JoanaCatarino/Adaptive-decision-making-task/Images/23.png

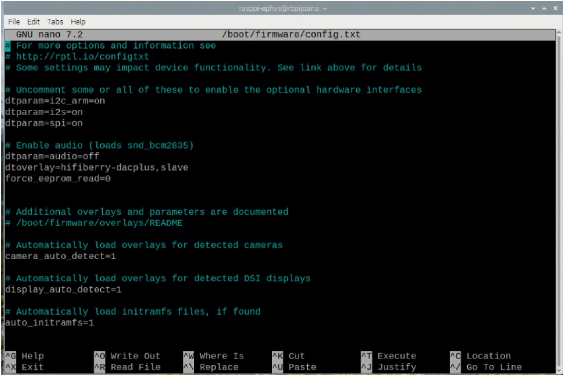
Images/23.png
