JoanaCatarino/Adaptive-decision-making-task/Task_GUI_Joana/gui_controls.py

# -*- coding: utf-8 -*-
"""
Created on Wed Oct  2 15:09:03 2024

@author: JoanaCatarino
"""
import matplotlib
matplotlib.use('Qt5Agg')

import sys
import cv2
import threading
import serial
import time
import random
import subprocess

import asyncio

from PyQt5.QtWidgets import QApplication, QWidget, QVBoxLayout, QLabel, QMainWindow, QSizePolicy
from PyQt5.QtGui import QFont, QImage, QPixmap
from PyQt5.QtCore import pyqtSlot, QTimer, QDate, Qt, QThread
from PyQt5.QtGui import QIntValidator, QDoubleValidator
from qasync import QEventLoop, asyncSlot  # Import qasync for async integration
from form_updt import Ui_TaskGui

# Import different functions/classes
from animal_id_generator import animal_id
from box_generator import box
from task_generator import task
from date_updater import DateUpdater
from chronometer_generator import Chronometer
from file_writer import create_data_file
from stylesheet import stylesheet
from camera_thread import CameraThread
from piezo_plot import LivePlotWidget
from performance_plot import PlotLicks
from performance_plot_advanced import PlotPerformance
from piezo_reader import PiezoReader
from calibration_pumps import calibration_pumps
from calibration_opto_10ms import calibration_opto_10ms
from calibration_opto_100ms import calibration_opto_100ms
from gpio_map import *

# Import task classes
from task_test_rig import TestRig
from task_free_licking import FreeLickingTask
from task_twochoice_auditory_blocks import TwoChoiceAuditoryTask_Blocks
from task_twochoice_auditory import TwoChoiceAuditoryTask
from task_adaptive_sensorimotor import AdaptiveSensorimotorTask
from task_adaptive_sensorimotor_distractor import AdaptiveSensorimotorTaskDistractor

# Import recording protocols as tasks
from passive_protocol_sounds import PassiveSoundRecordings



class GuiControls:
    def __init__(self, ui, updateTime_slot):
        self.ui = ui
        self.updateTime_slot = updateTime_slot

        style = stylesheet(self.ui) # to call the function with buttons' stylesheet
        self.current_task = None # set the initial task value
        self.camera_thread = None

        # initialize components defined by functions:
        self.populate_ddm_animalID() # dropdown menu with animal IDs
        self.populate_ddm_box() # dropdown menu with box numbers
        self.OV_animalID() # txt with animal ID in overview tab
        self.OV_box() # txt with box number in the overview tab
        self.OV_task() # txt with task protocol name in the overview tab
        self.populate_ddm_task() # dropdown menu with different task names
        self.setup_date() # Date
        self.setup_chronometer() # Chronometer
        self.connect_buttons() # Start, Stop and Update buttons
        self.disable_controls() # Disable all the controls for the test rig 'task' - Can only be activated when task is selected
        self.connect_text_changes() # inputs received in the QLineEdits
        self.check_update_state()
        self.camera_timer = QTimer()
        self.cap = cv2.VideoCapture() # initializing cam without open
        stylesheet(self.ui)
        
        # Connect dropdown menu with animal ID in box tab to the animal ID txt in the overview tab
        self.ui.ddm_Animal_ID.currentIndexChanged.connect(self.OV_animalID)
        # Connect dropdown menu with box number to the box txt in the overview tab
        self.ui.ddm_Box.currentIndexChanged.connect(self.OV_box)
        # Connect dropdown menu with task protocol to the task txt in the overview tab
        self.ui.ddm_Task.currentIndexChanged.connect(self.OV_task)
        # Initialize button states (to enable/disable start and stop buttons)
        self.update_button_states()
        # Initialize validators for QLineEdit widgets - to only accept numbers as input
        self.setup_validators()
        # Connect the task combobox to the method for enabling/disabling QLineEdits
        self.ui.ddm_Task.currentIndexChanged.connect(self.update_qlineedit_states)
        # Connect dropdown menu changes to check start button state method (so that you need to select animal info before starting the task)
        self.ui.ddm_Animal_ID.currentIndexChanged.connect(self.check_start_button_state)
        self.ui.ddm_Task.currentIndexChanged.connect(self.check_start_button_state)
        self.ui.ddm_Box.currentIndexChanged.connect(self.check_start_button_state)
        # Initial buttom state check
        self.check_start_button_state

        # Initialize funtions related to piezo
        self.piezo_reader = PiezoReader() # Initialize piezo reader
        self.setup_piezo_plots() # Set up the piezo plot
        self.piezo_timer = QTimer()
        self.piezo_timer.timeout.connect(self.update_piezo_plots)
        self.piezo_timer.setInterval(20)  # Refresh every 20 ms
        
        # Initialize functions for the performance plot
        self.setup_lick_plot()
        self.setup_performance_plot()
        
        # Set correct ranges for sliders based on your camera's capabilities
        self.ui.bar_Exposure.setMinimum(10)
        self.ui.bar_Exposure.setMaximum(626)
        
        self.ui.bar_Brightness.setMinimum(-64)
        self.ui.bar_Brightness.setMaximum(64)
        
        self.ui.bar_Contrast.setMinimum(0)
        self.ui.bar_Contrast.setMaximum(95)
            

    #Piezo functions
    def setup_piezo_plots(self):

        # Place live plots into GUI layout
        plt_layout1 = QVBoxLayout(self.ui.plt_LickTrace_Left)
        plt_layout1.setContentsMargins(0, 0, 0, 0)
        plt_layout1.setSpacing(0)
        self.live_plot1 = LivePlotWidget(self.piezo_reader.max_data_points, color= '#955C66', parent=self.ui.plt_LickTrace_Left)
        self.live_plot1.setSizePolicy(QSizePolicy.Expanding, QSizePolicy.Expanding)
        plt_layout1.addWidget(self.live_plot1)
        self.ui.plt_LickTrace_Left.setLayout(plt_layout1)

        plt_layout2 = QVBoxLayout(self.ui.plt_LickTrace_Right)
        plt_layout2.setContentsMargins(0, 0, 0, 0)
        plt_layout2.setSpacing(0)
        self.live_plot2 = LivePlotWidget(self.piezo_reader.max_data_points, color= '#4E8070', parent=self.ui.plt_LickTrace_Right)
        self.live_plot2.setSizePolicy(QSizePolicy.Expanding, QSizePolicy.Expanding)
        plt_layout2.addWidget(self.live_plot2)
        self.ui.plt_LickTrace_Right.setLayout(plt_layout2)

    def update_piezo_plots(self):
        # read serial data
        self.piezo_reader.read_serial_data()
        # Update each piezo plot with new data
        self.live_plot1.update_plot(self.piezo_reader.piezo_adder1)  # Update Left Piezo Plot
        self.live_plot2.update_plot(self.piezo_reader.piezo_adder2)  # Update Right Piezo Plot
        
    
    def setup_lick_plot(self):
        # Licks plot in the main tab
        plt_layout1 = QVBoxLayout(self.ui.plt_AnimalPerformance)
        plt_layout1.setContentsMargins(0, 0, 0, 0)
        plt_layout1.setSpacing(0)
        
        self.lick_plot = PlotLicks(parent=self.ui.plt_AnimalPerformance)  # Create stair plot
        self.lick_plot.setSizePolicy(QSizePolicy.Expanding, QSizePolicy.Expanding)
        
        plt_layout1.addWidget(self.lick_plot)
        self.ui.plt_AnimalPerformance.setLayout(plt_layout1)
        
        # Licks plot in the overview tab
        plt_layout2 = QVBoxLayout(self.ui.plt_AnimalPerformance)
        plt_layout2.setContentsMargins(0, 0, 0, 0)
        plt_layout2.setSpacing(0)
        
        self.lick_plot_ov = PlotLicks(parent=self.ui.OV_plt_AnimalPerformance)  # Create stair plot
        self.lick_plot_ov.setSizePolicy(QSizePolicy.Expanding, QSizePolicy.Expanding)
        
        plt_layout2.addWidget(self.lick_plot_ov)
        self.ui.OV_plt_AnimalPerformance.setLayout(plt_layout2)

    
    def update_lick_plot(self, total_licks, licks_left, licks_right, total_trials):
        if hasattr(self, 'lick_plot'):
            self.lick_plot.update_plot(total_licks, licks_left, licks_right, total_trials)
            
        if hasattr(self, 'lick_plot_ov'):
            self.lick_plot_ov.update_plot(total_licks, licks_left, licks_right, total_trials)
            
    
    def setup_performance_plot(self):
        # Licks plot in the main tab
        plt_layout1 = QVBoxLayout(self.ui.plt_AnimalPerformance)
        plt_layout1.setContentsMargins(0, 0, 0, 0)
        plt_layout1.setSpacing(0)
        
        self.performance_plot = PlotPerformance(parent=self.ui.plt_AnimalPerformance)  # Create stair plot
        self.performance_plot.setSizePolicy(QSizePolicy.Expanding, QSizePolicy.Expanding)
        
        plt_layout1.addWidget(self.performance_plot)
        self.ui.plt_AnimalPerformance.setLayout(plt_layout1)
        
        # Licks plot in the overview tab
        plt_layout2 = QVBoxLayout(self.ui.plt_AnimalPerformance)
        plt_layout2.setContentsMargins(0, 0, 0, 0)
        plt_layout2.setSpacing(0)
        
        self.performance_plot_ov = PlotPerformance(parent=self.ui.OV_plt_AnimalPerformance)  # Create stair plot
        self.performance_plot_ov.setSizePolicy(QSizePolicy.Expanding, QSizePolicy.Expanding)
        
        plt_layout2.addWidget(self.performance_plot_ov)
        self.ui.OV_plt_AnimalPerformance.setLayout(plt_layout2)

    
    def update_performance_plot(self, total_trials, correct_trials, incorrect_trials):
        if hasattr(self, 'performance_plot'):
            self.performance_plot.update_plot(total_trials, correct_trials, incorrect_trials)
            
        if hasattr(self, 'performance_plot_ov'):
            self.performance_plot_ov.update_plot(total_trials, correct_trials, incorrect_trials)  
    
    
    def populate_ddm_animalID(self):
        # Populate the dropdown menu for Animal_ID
        font_size = 8
        animal_id(self.ui.ddm_Animal_ID)


    def OV_animalID(self):
        selected_animal = self.ui.ddm_Animal_ID.currentText() # Covert string to integer

        # Check if the selected value is numeric (integer or float)
        if selected_animal.replace('.', '', 1).isdigit():  # Checks for integers and floats
            if '.' in selected_animal:
                selected_animal = float(selected_animal)  # Convert to float if it has a decimal point
            else:
                selected_animal = int(selected_animal)  # Convert to integer if no decimal point

        # Update the txt, whether it's a string or a number
        self.ui.OV_txt_AnimalID.setText(f'{selected_animal}')

    def populate_ddm_box(self):
        # populate the dropdown menu for box
        font_size = 8
        box(self.ui.ddm_Box)

    def OV_box(self):
        selected_box = self.ui.ddm_Box.currentText()

        if selected_box.replace('.', '', 1).isdigit():
            if '.' in selected_box:
                selected_box = float(selected_box)
            else:
                selected_box = int(selected_box)

        self.ui.OV_txt_Box.setText(f'{selected_box}')

    def populate_ddm_task(self):
        font_size = 8
        task(self.ui.ddm_Task, font_size=8)
        
   
    def OV_task(self):
        selected_task = self.ui.ddm_Task.currentText()
        self.ui.OV_txt_Task.setText(f'{selected_task}')


    def setup_date(self):
        # Create and configure a DateUpdater
        self.date_updater = DateUpdater(self.ui.txt_Date, font_size=9)


    def setup_chronometer(self):
        # Initialize Chronometer
        self.txt_Chronometer = Chronometer() # Chronometer for general box tab
        self.txt_Chronometer.timeChanged.connect(self.updateTime_slot)

        self.OV_box_Chronometer = Chronometer() # Chronometer Overview tab
        self.OV_box_Chronometer.timeChanged.connect(self.updateTime_slot)
        
    
    def calibration(self):
        try:
            print('Starting calibration of pumps')
            calibration_pumps()
        except Exception as e:
            print(f'Calibration failed:{e}')
            
    def test_opto_10ms(self):
        try:
            print('Starting test for 10ms opto')
            calibration_opto_10ms()
        except Exception as e:
            print(f'Test failed:{e}')
            
    def test_opto_100ms(self):
        try:
            print('Starting test for 100ms opto')
            calibration_opto_100ms()
        except Exception as e:
            print(f'Test failed:{e}')
            
            
            
    '''
    def start_camera(self):
        start_camera(self.cap, self.camera_timer, self.update_frame)

    def stop_camera(self):
        stop_camera(self.cap, self.ui.plt_Camera, self.ui.OV_plt_Camera)

    def update_frame(self):
        update_frame(self.cap, self.ui.plt_Camera, self.ui.OV_plt_Camera)
    '''
    
    def start_camera(self): 
        self.camera_thread = CameraThread()
        self.camera_thread.frameCaptured.connect(self.update_frame)
        self.camera_thread.cameraStatus.connect(self.update_camera_status)
        self.camera_thread.start()
        
    def update_camera_status(self, status):
        if status:
            self.ui.lbl_CameraStatus.setText("Connected")
            self.ui.lbl_CameraStatus.setStyleSheet("color: green;")
        else:
            self.ui.lbl_CameraStatus.setText("Not connected")
            self.ui.lbl_CameraStatus.setStyleSheet("color: red;")
        
    def stop_camera(self):
        if self.camera_thread:
            self.camera_thread.stop()
            self.camera_thread = None
    
        # Clear camera display in GUI widgets
        self.ui.plt_Camera.clear()
        self.ui.OV_plt_Camera.clear()
    
    def update_frame(self, frame):
        frame = cv2.cvtColor(frame, cv2.COLOR_BGR2GRAY)
        h, w = frame.shape
        bytes_per_line = w
        image = QImage(frame.data, w, h, bytes_per_line, QImage.Format_Grayscale8)
        pixmap = QPixmap.fromImage(image)
    
        # Update both camera display widgets
        self.ui.plt_Camera.setPixmap(pixmap.scaled(self.ui.plt_Camera.size(), Qt.KeepAspectRatio))
        self.ui.OV_plt_Camera.setPixmap(pixmap.scaled(self.ui.OV_plt_Camera.size(), Qt.KeepAspectRatio))
        
    def update_camera_exposure(self, value):
        # Disable auto exposure first
        subprocess.run(["v4l2-ctl", "-d", "/dev/video0", "--set-ctrl", "auto_exposure=1"])
    
        # Then set manual exposure value
        subprocess.run(["v4l2-ctl", "-d", "/dev/video0", "--set-ctrl", f"exposure_time_absolute={value}"])

    def update_camera_brightness(self, value):
        subprocess.run(["v4l2-ctl", "-d", "/dev/video0", "--set-ctrl", f"brightness={value}"])
    
    def update_camera_contrast(self, value):
        subprocess.run(["v4l2-ctl", "-d", "/dev/video0", "--set-ctrl", f"contrast={value}"])
        
    def reset_camera_settings(self):
        # Reset all to default values
        subprocess.run(["v4l2-ctl", "-d", "/dev/video0", "--set-ctrl", "auto_exposure=3"])
        subprocess.run(["v4l2-ctl", "-d", "/dev/video0", "--set-ctrl", "exposure_time_absolute=156"])
        subprocess.run(["v4l2-ctl", "-d", "/dev/video0", "--set-ctrl", "brightness=0"])
        subprocess.run(["v4l2-ctl", "-d", "/dev/video0", "--set-ctrl", "contrast=12"])
    
        self.ui.bar_Exposure.setValue(156)
        self.ui.bar_Brightness.setValue(0)
        self.ui.bar_Contrast.setValue(12)

            
    def flush_water_left(self):
        """Flush water in the left spout."""
        flush_duration = 0.08 # seconds - Change according to calibration
        pump_l.off()
        time.sleep(flush_duration)
        pump_l.on()   
        
    def flush_water_right(self):
        """Flush water in the right spout."""
        flush_duration = 0.08  # seconds - Change according to calibration
        pump_r.off()
        time.sleep(flush_duration)
        pump_r.on() 
        
    def check_arduino_connection(self):
        if self.piezo_reader.ser and self.piezo_reader.ser.is_open:
            self.ui.lbl_ArduinoStatus.setText("Connected")
            self.ui.lbl_ArduinoStatus.setStyleSheet("color: green;")
        else:
            self.ui.lbl_ArduinoStatus.setText("Not connected")
            self.ui.lbl_ArduinoStatus.setStyleSheet("color: red;")
            
    def check_hardware_connections(self):
        self.check_arduino_connection()
        self.start_camera()  # Will trigger update_camera_status

    def check_start_button_state(self):
        # Check if all dropdown menus have a selected value
        animal_selected = self.ui.ddm_Animal_ID.currentText() != ''
        task_selected = self.ui.ddm_Task.currentText() != ''
        box_selected = self.ui.ddm_Box.currentText() != ''

        # Enable the Start button only if all dropdown menus have something selected
        self.ui.btn_Start.setEnabled(animal_selected and task_selected and box_selected)

    def connect_buttons(self):
        # Connect Start and Stop buttons + update button
        self.ui.btn_Start.clicked.connect(self.execute_task)
        self.ui.btn_Stop.clicked.connect(self.stop_task)
        #self.ui.btn_Update.clicked.connect(self.print_variables)
        self.ui.btn_Update.clicked.connect(self.update_task_params)
        self.ui.btn_FlushWater_left.clicked.connect(self.flush_water_left)
        self.ui.btn_FlushWater_right.clicked.connect(self.flush_water_right)
        self.ui.bar_Exposure.valueChanged.connect(self.update_camera_exposure)
        self.ui.bar_Brightness.valueChanged.connect(self.update_camera_brightness)
        self.ui.bar_Contrast.valueChanged.connect(self.update_camera_contrast)
        self.ui.btn_cam_reset.clicked.connect(self.reset_camera_settings)
        self.ui.btn_CheckHardware.clicked.connect(self.check_hardware_connections)
        self.ui.btn_Calibration.clicked.connect(self.calibration)
        self.ui.btn_Opto10.clicked.connect(self.test_opto_10ms) #10ms opto test
        self.ui.btn_Opto100.clicked.connect(self.test_opto_100ms) #100ms opto test

    def connect_text_changes(self):
        # Check for inputs received in the QLineEdits
        self.ui.txt_QuietWindow.textChanged.connect(self.check_update_state)
        self.ui.txt_ResponseWindow.textChanged.connect(self.check_update_state)
        self.ui.txt_ITImin.textChanged.connect(self.check_update_state)
        self.ui.txt_ITImax.textChanged.connect(self.check_update_state)
        self.ui.txt_ValveOpening.textChanged.connect(self.check_update_state)
        self.ui.txt_ThresholdLeft.textChanged.connect(self.check_update_state)
        self.ui.txt_ThresholdRight.textChanged.connect(self.check_update_state)
        self.ui.txt_Blocks.textChanged.connect(self.check_update_state)

    def update_button_states(self):
        # Update the enabled/disabled state of the Start and Stop buttons
        if self.current_task:
            self.ui.btn_Start.setEnabled(False) # Disable start if task is running
            self.ui.btn_Stop.setEnabled(True)   # Enable stop if a task is running
        else:
            self.ui.btn_Start.setEnabled(True)  # Enable start if no task is running
            self.ui.btn_Stop.setEnabled(False)  # Disable stop if no task is running


    def setup_validators(self):
        # Create validators
        self.int_validator = QIntValidator()
        self.float_validator = QDoubleValidator()

        #Set validators to QLineEdit widgets - To only accept numbers as input
        self.ui.txt_QuietWindow.setValidator(self.float_validator)
        self.ui.txt_ResponseWindow.setValidator(self.float_validator)
        self.ui.txt_ITImin.setValidator(self.float_validator)
        self.ui.txt_ITImax.setValidator(self.float_validator)
        self.ui.txt_ValveOpening.setValidator(self.float_validator)
        self.ui.txt_ThresholdLeft.setValidator(self.float_validator)
        self.ui.txt_ThresholdRight.setValidator(self.float_validator)
        self.ui.txt_Blocks.setValidator(self.float_validator)


    def check_update_state(self):
        # Enable or disable the update button based on the QLineEdit content
        
        if (
            self.ui.txt_QuietWindow.text().strip()
            or self.ui.txt_ResponseWindow.text().strip()
            or self.ui.txt_ITImin.text().strip()
            or self.ui.txt_ITImax.text().strip()
            or self.ui.txt_ValveOpening.text().strip()
            or self.ui.txt_ThresholdLeft.text().strip()
            or self.ui.txt_ThresholdRight.text().strip()
            or self.ui.txt_Blocks.text().strip()
            ):
            
            self.ui.btn_Update.setEnabled(True)
        else:
            self.ui.btn_Update.setEnabled(False)


    def update_qlineedit_states(self):
        # Enable or disable QLineEdits based on the selected task
        selected_task = self.ui.ddm_Task.currentText()
        enable = selected_task not in ('','Test rig') # Make the QLineEdits be disabled when no task is selected or when test rig is selected
        self.ui.txt_QuietWindow.setEnabled(enable)
        self.ui.txt_ResponseWindow.setEnabled(enable)
        self.ui.txt_ITImin.setEnabled(enable)
        self.ui.txt_ITImax.setEnabled(enable)
        self.ui.txt_ValveOpening.setEnabled(enable)
        self.ui.chk_NoPunishment.setEnabled(enable)
        self.ui.chk_IgnoreLicksWW.setEnabled(enable)
        self.ui.txt_Blocks.setEnabled(enable)

    # set enable and disable functions for the test rig controls
    def enable_controls(self):
        self.ui.chk_BlueLED.setEnabled(True)
        self.ui.chk_WhiteLED_Left.setEnabled(True)
        self.ui.chk_WhiteLED_Right.setEnabled(True)
        self.ui.chk_16Tone.setEnabled(True)
        self.ui.chk_8Tone.setEnabled(True)
        self.ui.chk_Reward_left.setEnabled(True)
        self.ui.chk_Reward_right.setEnabled(True)
        self.ui.chk_Punishment.setEnabled(True)
        self.ui.chk_Manip_sound_lights.setEnabled(True)

    def disable_controls(self):
        self.ui.chk_BlueLED.setEnabled(False)
        self.ui.chk_WhiteLED_Left.setEnabled(False)
        self.ui.chk_WhiteLED_Right.setEnabled(False)
        self.ui.chk_16Tone.setEnabled(False)
        self.ui.chk_8Tone.setEnabled(False)
        self.ui.chk_Reward_left.setEnabled(False)
        self.ui.chk_Reward_right.setEnabled(False)
        self.ui.chk_Punishment.setEnabled(False)
        self.ui.chk_Manip_sound_lights.setEnabled(False)
        


    def execute_task(self):

        # Stop any currently running task
        if self.current_task and hasattr(self.current_task, 'stop'):
            self.stop_task()

        # Ensure the camera is stopped and restarted
        self.stop_camera()
        self.start_camera()

        # Ensure piezo are stopped and Start the piezo update timer
        self.piezo_timer.stop()
        self.piezo_timer.start()

        # Read the selected task from the dropdown menu
        selected_task = self.ui.ddm_Task.currentText()
        
        # Reset counters
        self.total_trials = 0
        self.total_licks = 0 
        self.licks_left = 0 
        self.licks_right = 0 
        self.correct_trials = 0
        self.incorrect_trials = 0
        self.early_licks = 0
        self.omissions = 0
        self.trial_duration = 0
        self.sound_8KHz = 0
        self.sound_16KHz = 0
        self.action_left_block_count = 0
        self.action_right_block_count = 0
        self.catch_trials = 0
        
        # Update GUI display
        self.update_total_licks(0)
        self.update_licks_left(0)
        self.update_licks_right(0)
        self.update_correct_trials(0)
        self.update_incorrect_trials(0)
        self.update_early_licks(0)
        self.update_omissions(0)
        self.update_trial_duration(0)
        self.update_sound_8KHz(0)
        self.update_sound_16KHz(0)
        self.update_action_l_blocks(0)
        self.update_action_r_blocks(0)
        self.update_catch_trials(0)
        
        #Reset labels for trial monitor
        for col in range(1, 16):  # Assuming 15 trials are displayed

            # **Reset Outcome Labels (`lbl_Ox`)**
            lbl_outcome = getattr(self.ui, f"lbl_O{col}", None)
            if lbl_outcome:
                lbl_outcome.setStyleSheet("")  # Clear color
                lbl_outcome.setText("")  # Remove text
    
            # **Reset Block Labels (`lbl_Bx`)**
            lbl_block = getattr(self.ui, f"lbl_B{col}", None)
            if lbl_block:
                lbl_block.setText("")  # Remove block type
    
            # **Reset Trial Number Labels (`lbl_Tx`)**
            lbl_T = getattr(self.ui, f"lbl_T{col}", None)
            if lbl_T:
                lbl_T.setText("")  # Remove trial number


        # Create file with data unless the selected task is 'Test rig'
        if selected_task != 'Test rig':
             csv_file_path, _ = create_data_file(self.ui.txt_Date, self.ui.ddm_Animal_ID, self.ui.ddm_Task, self.ui.ddm_Box)

        # === Dynamically Update Plots Based on Task ===
    
        # Remove existing plots from main tab
        layout_main = self.ui.plt_AnimalPerformance.layout()
        if layout_main is not None:
            while layout_main.count():
                item = layout_main.takeAt(0)
                widget = item.widget()
                if widget is not None:
                    widget.deleteLater()
    
        # Remove existing plots from overview tab
        layout_ov = self.ui.OV_plt_AnimalPerformance.layout()
        if layout_ov is not None:
            while layout_ov.count():
                item = layout_ov.takeAt(0)
                widget = item.widget()
                if widget is not None:
                    widget.deleteLater()
    
        # Select plot based on the task
        if selected_task in ['Two-Choice Auditory Task', 'Adaptive Sensorimotor Task', 'Adaptive Sensorimotor Task w/ Distractor','Two-Choice Levers Task', 'Two-Choice Auditory Task Blocks', 'Two-Choice Levers Task Blocks']:
            # Use performance plot for decision-based tasks
            self.performance_plot = PlotPerformance(parent=self.ui.plt_AnimalPerformance)
            layout_main.addWidget(self.performance_plot)
    
            self.performance_plot_ov = PlotPerformance(parent=self.ui.OV_plt_AnimalPerformance)
            layout_ov.addWidget(self.performance_plot_ov)
        
        else:
            # Use licks plot for other tasks
            self.lick_plot = PlotLicks(parent=self.ui.plt_AnimalPerformance)
            layout_main.addWidget(self.lick_plot)
    
            self.lick_plot_ov = PlotLicks(parent=self.ui.OV_plt_AnimalPerformance)
            layout_ov.addWidget(self.lick_plot_ov)
    
        self.ui.plt_AnimalPerformance.setLayout(layout_main)
        self.ui.OV_plt_AnimalPerformance.setLayout(layout_ov)


        if selected_task == 'Test rig':

            # run test rig
            self.current_task = TestRig(self.ui)
            self.enable_controls()

        elif selected_task == 'Free Licking':
            self.current_task = FreeLickingTask(self, csv_file_path)

        elif selected_task == 'Two-Choice Auditory Task':
            self.current_task = TwoChoiceAuditoryTask(self, csv_file_path)

        elif selected_task == 'Adaptive Sensorimotor Task':
            self.current_task = AdaptiveSensorimotorTask(self, csv_file_path)

        elif selected_task == 'Adaptive Sensorimotor Task w/ Distractor':
            self.current_task = AdaptiveSensorimotorTaskDistractor(self, csv_file_path)
            
        elif selected_task == 'Two-Choice Auditory Task Blocks':
            self.current_task = TwoChoiceAuditoryTask_Blocks(self, csv_file_path)
            
        elif selected_task == 'Recording - Passive protocol sounds':
            self.current_task = PassiveSoundRecordings(self)
       
        
        if self.current_task:
            self.current_task.start()
            self.txt_Chronometer.start()
            self.OV_box_Chronometer.start() # start overview chronometer for Box1

        else:
            self.disable_controls()


        # Update QLineEdit states based on the selected task
        self.update_qlineedit_states()

        # Update start/stop button states
        self.update_button_states()


    def stop_task(self):

        if self.current_task and hasattr(self.current_task, 'stop'):
            self.current_task.stop()
            self.current_task = None

        # Stop the chronometer
        self.txt_Chronometer.stop()
        self.OV_box_Chronometer.stop() # stop overview chronometer for Box1

        # Stop the camera
        self.stop_camera()

        # Stop the piezo update timer
        if self.piezo_timer.isActive():
            self.piezo_timer.stop()

        # Disable test rig controls
        self.disable_controls()

        # Update start/stop button states
        self.update_button_states()


    def update_total_licks(self, total_licks):
        # Update the QLabel with the total trials count
        self.ui.box_TotalLicks.setText(f'{total_licks}')
        self.ui.OV_box_TotalLicks.setText(f'{total_licks}')
        
    def update_licks_left(self, licks_left):
        self.ui.box_LicksLeft.setText(f'{licks_left}')
        
    def update_licks_right(self, licks_right):
        self.ui.box_LicksRight.setText(f'{licks_right}')
        
    def update_total_trials(self, total_trials):
        self.ui.box_TotalTrials.setText(f'{total_trials}')
        self.ui.OV_box_TotalTrials.setText(f'{total_trials}') 
        
    def update_correct_trials(self, correct_trials):
        self.ui.box_CorrectTrials.setText(f'{correct_trials}')
        self.ui.OV_box_CorrectTrials.setText(f'{correct_trials}')     
        
    def update_incorrect_trials(self, incorrect_trials):
        self.ui.box_IncorrectTrials.setText(f'{incorrect_trials}')
        self.ui.OV_box_IncorrectTrials.setText(f'{incorrect_trials}')     
        
    def update_early_licks(self, early_licks):
        self.ui.box_EarlyLicks.setText(f'{early_licks}')
      
    def update_omissions(self, omissions):
        self.ui.box_Omissions.setText(f'{omissions}')
        self.ui.OV_box_Omissions.setText(f'{omissions}') 
        
    def update_trial_duration(self, trial_duration):
        self.ui.box_TrialDuration.setText(f'{trial_duration:.2f}')
        
    def update_sound_8KHz(self, sound_8KHz):
        self.ui.box_8KHzTrials.setText(f'{sound_8KHz}')
        
    def update_sound_16KHz(self, sound_16KHz):
        self.ui.box_16KHzTrials.setText(f'{sound_16KHz}')
        
    def update_sound_blocks(self, sound_block_count):
        self.ui.box_SoundBlocks.setText(f'{sound_block_count}')
        
    def update_action_r_blocks(self, action_right_block_count):
        self.ui.box_Action_R_blocks.setText(f'{action_right_block_count}')
        
    def update_action_l_blocks(self, action_left_block_count):
        self.ui.box_Action_L_blocks.setText(f'{action_left_block_count}')
        
    def update_catch_trials(self, catch_trials):
        self.ui.box_CatchTrials.setText(f'{catch_trials}')
        

    
    def update_task_params(self):
        # Input new variables in the Gui and update them real time in the current task
            try:
                # Get the values from the GUI
                quiet_window = self.ui.txt_QuietWindow.text()
                response_window = self.ui.txt_ResponseWindow.text()
                ITImin = self.ui.txt_ITImin.text()
                ITImax = self.ui.txt_ITImax.text()
                valve_opening = self.ui.txt_ValveOpening.text()  # For led_on_duration/pump
                threshold_left = self.ui.txt_ThresholdLeft.text()  # For left piezo threshold
                threshold_right = self.ui.txt_ThresholdRight.text()  # For right piezo threshold
                block_size = self.ui.txt_Blocks.text()
        
                # Validate and convert inputs to floats
                new_quiet_window = float(quiet_window) if quiet_window else None
                new_response_window = float(response_window) if response_window else None
                new_ITImin = float(ITImin) if ITImin else None
                new_ITImax = float(ITImax) if ITImax else None
                new_valve_opening = float(valve_opening) if valve_opening else None
                new_threshold_left = float(threshold_left) if threshold_left else None
                new_threshold_right = float(threshold_right) if threshold_right else None
                new_block_size = float(block_size) if block_size else None
        
                # Ensure there's a running task and it's of the correct type
                if self.current_task and isinstance(self.current_task, (FreeLickingTask, TwoChoiceAuditoryTask, AdaptiveSensorimotorTask, AdaptiveSensorimotorTaskDistractor, TwoChoiceAuditoryTask_Blocks, PassiveSoundRecordings)):
                    # Update quiet window
                    if new_quiet_window is not None:
                        self.current_task.QW = int(new_quiet_window)
                        print(f"Quiet window: {new_quiet_window} s")
                        self.ui.btn_Update.setEnabled(False)
                    
                    # Update response window
                    if new_response_window is not None:
                        self.current_task.RW = new_response_window
                        print(f"Response window: {new_response_window} s")
                        self.ui.btn_Update.setEnabled(False)
                        
                    # Update ITI interval - min value
                    if new_ITImin is not None:
                        self.current_task.ITI_min = new_ITImin
                        print(f"ITImin: {new_ITImin}")
                        self.ui.btn_Update.setEnabled(False)
                        
                    # Update ITI interval - min value
                    if new_ITImax is not None:
                        self.current_task.ITI_max = new_ITImax
                        print(f"ITImin: {new_ITImax}")
                        self.ui.btn_Update.setEnabled(False)
                  
                    # Update valve opening
                    if new_valve_opening is not None:
                        self.current_task.valve_opening = new_valve_opening
                        print(f"Valve opening: {new_valve_opening} s")
                        self.ui.btn_Update.setEnabled(False)
                    
                    # Update threshold_left
                    if new_threshold_left is not None: 
                        self.current_task.threshold_left = new_threshold_left
                        print(f"Threshold left piezo: {new_threshold_left}")
                        self.ui.btn_Update.setEnabled(False)
                    
                    # Update threshold_right
                    if new_threshold_right is not None:
                        self.current_task.threshold_right = new_threshold_right
                        print(f"Threshold right piezo: {new_threshold_right}")
                        self.ui.btn_Update.setEnabled(False)
                        
                    # Update Block_size
                    if new_block_size is not None:
                        self.current_task.block_size = new_block_size
                        print(f'Block size: {new_block_size}')
                        self.ui.btn_Update.setEnabled(False)
                    
                else:
                    print("No active Task or invalid task type.")
            except ValueError:
                print("Invalid input for one or more parameters. Please enter valid numbers.")
    
