JoanaCatarino/Adaptive-decision-making-task/Task_GUI_Joana/animal_id_generator.py

# -*- coding: utf-8 -*-
"""
Created on Sat Jul 13 17:44:52 2024

@author: JoanaCatarino

Populates the animal_id drop down menu in the GUI with the animals added here in items
"""

import sys
from PyQt5.QtWidgets import QApplication, QWidget, QVBoxLayout, QComboBox
from PyQt5.QtGui import QFont  # Import QFont for font manipulation

def animal_id(combobox, font_size=8):
    items = ["Test-animal", "1105695", "1105696", "1107081", "1107080", "1105692", "1105693", "1112090", "1114859", "1119556", "1119526"]
    
    # Create a font with the specified size
    font = QFont()
    font.setPointSize(font_size)
    
    # Apply the font to the combo box
    combobox.setFont(font)
    
    for item in items:
        combobox.addItem(item)
