JoanaCatarino/Adaptive-decision-making-task/(commit log)

2024-07-16 Functions update
    - sound_generator function to generate a 5KHz tone, 10KHz tone and white noise
    - animal_id_generator function to input animal IDs to dropdown menu
    - TaskController - new copy of the task_gui.py script to make alteration in the core code of the buttons
    [animal_id_generator.py, sound_generator.py, taskController.py]
2024-07-17 add chronometer to start counting with start button
2024-07-20 Add tasks + start/stop button funtion
    - Add new files with task class for each of the tasks
    - connected all the tasks to the start button that initiates the task that it is selected in the drop-down menu of tasks
    - start writing the test rig task
2024-07-24 Add code for server and client - connection through websockets to make the PC (server) communicate with the raspberry pi (client)
2024-07-25 Add 'update' button to the gui + updated file_writer to create folders with the animal_id and save the .txt files in those folders
2024-07-26 Add files for tests of communication between pc and raspberry pi
    - hardware.py
    - client.py
    - Taskcontroller.py
2024-07-29 Revert "update function map"
    This reverts commit 2b3fddffd9364532094b7b97e87d35e2dcfeb894.
    [taskController.py]
2024-07-29 Revert "update pins"
    This reverts commit 6479b0abc8a79992d02ae77910ac43dc477cc2ea.
    [gpio_map.py]
2024-08-05 Added update button connection to QLineEdits - only on the server side so far
2024-08-06 Added test for piezo using buttons with RPi - only working on client side
2024-08-09 Updates in different files + almost final free licking script with buttons
2024-08-09 Updates gpio map + bug fix free licking
    [gpio_map.py, task_free_licking.py]
2024-08-09 Bug fix free licking
    [task_free_licking.py]
2024-08-10 updated free licking task with buttons + changes txt to csv file in the file_writer.py and added .json + started script for spout-tone pairs generator
2024-10-02 fix task generator directory
    [gui_controls.py]
2024-10-02 fix background colors chronometer
    [gui_controls.py]
2024-10-02 first tests for start and stop buttons
2024-10-02 bug fix about current task attribute
    [gui_controls.py]
2024-10-03 tests timer
2024-10-03 bug fix test rig
    [gui_controls.py]
2024-10-03 update background color when time is reset in the overview tab
    [taskController.py]
2024-10-03 tests timer background color
2024-10-03 fix in execute tasks function
    [gui_controls.py]
2024-10-03 fix problem with execution of test rig task
    [gui_controls.py, task_free_licking.py, task_test_rig.py]
2024-10-03 new led functions
2024-10-03 test to give color to buttons
2024-10-04 test enable/disable buttons
2024-10-04 test enable/disable button
2024-10-04 tests colors enabled buttons
2024-10-04 style all disabled buttons
2024-10-04 tests update button
2024-10-07 new functions for update button
2024-10-07 bug fix for association trials
    [gui_controls.py]
2024-10-07 bug fix in check update button states to enable/disable
    [gui_controls.py, ui_form.py]
2024-10-08 tests camera
2024-10-11 camera tests
2024-10-15 removed camera
2024-10-15 bug fix for cam size
    [gui_controls.py]
2024-10-15 update stop function for camera
2024-10-15 bug fix camera
2024-10-15 update OV camera to Qlabel
2024-10-15 bug fix with cam restart
    [gui_controls.py]
2024-10-16 test free licking with buttons
2024-10-16 new script to test free licking with buttons
2024-11-05 bug fix file writer
    [file_writer.py]
2024-11-05 Add lines to create criteria to enable start button
2024-11-06 updates on free licking task - buttons version
2024-11-06 bug fix attempt 2
    [gui_controls.py, task_free_licking.py]
2024-11-06 Change in threads
2024-11-06 countdown printing fixed
2024-11-06 updates to reset countdown after button press - FL
    [task_free_licking.py]
2024-11-08 tests to update quiet window during free licking with the gui + update button
2024-12-09 adding Arduino script
2024-12-11 test for sequence of leds
2025-01-13 added led description
2025-01-13 added lambda to check button
2025-01-13 add arg parameter to the led blinking functions to test
2025-01-13 test for stop button
2025-01-14 test stop button
2025-01-14 bug fix stop function
    [task_test_rig.py]
2025-01-15 bug fix piezo reader
    [gui_controls.py]
2025-01-15 bug fix in piezo reader file
    [piezo_reader.py]
2025-01-15 test new freelicking task - just print piezo_adder1
2025-01-15 test to print last value of piezzo_adder1
2025-01-15 test - before this the printing of piezo_adder1 was kinda working
2025-01-15 printing piezo_adder is working! Now adding led shining everytime piezo_adder is bigger than an threshold of 10 (tests)
2025-01-15 code for the threshold and led works - threshold is now 5 to test
2025-01-15 test to implement led on duration
2025-01-15 All working fine for piezo_adder + led(pump) - now implementing the piezo_adder2 and another led(pump)
2025-01-15 bug fix to have the 2 piezos
    [task_free_licking.py]
2025-01-15 code is working with both piezos and leds. Now implementing total count
2025-01-16 test colors for trace
2025-01-17 bug fix for color trace
    [gui_controls.py]
2025-01-17 fix new format to save name files
    [file_writer.py]
2025-01-17 test update button with valve opening
2025-01-17 some bug fixs
    it is working fine for valve opening but now we are implementing the same thing for the piezo thresholds
    [gui_controls.py, task_free_licking.py]
2025-01-17 update code to enable/disable update button
2025-01-17 code to start testing the pumps. Until this point the freelicking was working fine with LEDS instead of pumps
2025-01-20 shutdown pumps in the beginning of the test_rig task
2025-01-20 test to shutdown pump when the gui is launched
2025-01-20 change code to shutdown pumps in the task_controller
2025-01-20 test to reset counter after start of new freelicking task
    [task_free_licking.py]
2025-01-20 bug fix to zero values in the gui
    [task_free_licking.py]
2025-01-21 test to shine the led every second and print time
2025-01-22 test to implement trial start - before this the task was working fine - blinking a LED every 1 sec and saving the time
2025-01-24 stop printing
2025-01-27 test to make pump work in this file
2025-01-28 change test rig file to its original script (blue led code to shine one led instead of a sequence) - code until here was working fine to shine a sequence
2025-01-28 fixed pumps (code)
2025-01-29 test to implement correct quiet window
    [task_spout_sampling.py]
2025-01-30 new script for free licking with several threads
2025-01-30 remove rewards from independent thread
2025-01-30 test with threads again
2025-02-06 change color trace in performance plot
2025-02-06 fix time axis plots
    [task_spout_sampling.py]
2025-02-06 test to fix y axis
    [performance_plot.py]
2025-02-06 implementation of reseting plot after new task
    [gui_controls.py, performance_plot.py, task_spout_sampling.py]
2025-02-06 Another test to reset the performance plot at the beginning of a new task
    [performance_plot.py, task_spout_sampling.py]
2025-02-10 test pump for test rig script
2025-02-10 pumps were solved but sounds are missing
    [gui_controls.py, task_free_licking.py]
2025-02-10 changed pin for LED from 5 to 6
2025-02-10 new buttons in the gui
2025-02-10 add enable to new buttons
2025-02-13 try to fix light
    [task_twochoice_auditory.py]
2025-02-13 fixes in the time
    [task_twochoice_auditory.py]
2025-02-13 fixes in the white noise
    [task_twochoice_auditory.py]
2025-02-13 test to fix rewards and punishments
    [task_twochoice_auditory.py]
2025-02-14 test with led
2025-02-14 try to fix led
    [task_twochoice_auditory.py]
2025-02-17 not print thresholds
2025-02-21 - assignment of tone-spout for each trial is working + Now testing only rewarding correct spout
    [task_twochoice_auditory.py]
2025-02-21 added some prints to check things
2025-02-21 implemented punishment for incorrect trials and is working + Now implementing counter for correct and incorrect trials
    [task_twochoice_auditory.py]
2025-02-21 counters for correct and incorrect trials are working + Now implementing omissions
    [task_twochoice_auditory.py]
2025-02-21 call the function with threads
2025-02-21 try without threads - threads were not working
    [task_twochoice_auditory.py]
2025-02-21 now detect licks show work all the time and is inside a thread
2025-02-21 omissions were not working, try again
    [task_twochoice_auditory.py]
2025-02-25 fixed waiting window but now need to fix the led turning off in omission trials
    [task_twochoice_auditory.py]
2025-02-25 still trying to fix it
    [task_twochoice_auditory.py]
2025-02-27 printing statement for checking code
2025-02-27 more printing
2025-02-27 more print statements
2025-02-27 print statements for check-up
2025-02-28 implement ignore licks during WW from Gui button
2025-02-28 implement no punishment with NoPunishment button forr early training stage
2025-02-28 implement Automatic reward for early stage training
2025-03-01 bug fix in gui design
    [ui_form.py]
2025-03-03 print statements to check trial duration
2025-03-03 trying to fix trial duration in the gui
    [gui_controls.py]
2025-03-03 updates on trial duration and 5/10KHz tone print in the gui
2025-03-04 test to try to disconnect checked button
2025-03-04 some fixes to make it better
    [performance_plot_advanced.py]
2025-03-04 add another y axis for d'
2025-03-05 more tests to reset the plots
    [gui_controls.py]
2025-03-05 start adaptive sensorimotor task
2025-03-06 stopped qw printing for tests
2025-03-06 implement 85% correct to move to new trial
    [task_adaptive_sensorimotor.py]
2025-03-06 implement current trial text in main tab
2025-03-06 test with old switching rule
2025-03-06 print current trial in OV tab
2025-03-06 test for new switching block rule
2025-03-06 silence 85% block switch
2025-03-10 some variables were still not working, new test
    [task_adaptive_sensorimotor.py]
2025-03-11 started code for adaptive sensorimotor task with distractor
    implementing distractor in 40% of catch trials and 40% of normal trials
2025-03-11 implement new save data format in the adaptive sensorimotor task
2025-03-11 some tests to reset counters
    [gui_controls.py, task_twochoice_auditory.py]
2025-03-12 small change in gui controls to allow correct plot
    [gui_controls.py]
2025-03-12 fix in spout sampling
    [task_spout_sampling.py]
2025-03-13 print statement for trials
2025-03-17 implement debiasing protocol in the adaptive sensorimotor task
2025-03-17 implement debias protocol in adaptive sensorimotor task with distractor
2025-03-19 some fixes for test monitor
    [task_adaptive_sensorimotor.py]
2025-03-19 Fixes in Gui design
    [ui_form.py]
2025-03-19 fixes in x axis plots
    [performance_plot_advanced.py, task_adaptive_sensorimotor.py]
2025-03-19 final test for adaptive sensorimotor task
2025-03-19 implement trial monitor for adaptive sensorimotor distractor
2025-03-19 change representation of block in case it is None
2025-03-19 try to implement camera again
2025-03-19 change camera settings
2025-04-04 add button in the gui
2025-04-04 Add button to flush water
2025-04-04 try to fix camera
    [camera_thread.py, gui_controls.py]
2025-04-07 set frame rate
2025-04-07 adjust size (not working so well)
    [gui_controls.py]
2025-04-07 add independent camera script
2025-04-07 make camera black and white - working before with colors just fine
2025-04-07 test with camera settings
2025-04-07 tests with camera
2025-04-07 add reset button to camera
2025-04-08 tests for hardware status button
2025-05-07 pump calibration
2025-05-07 pump calib
2025-05-09 update in valve opening for water delivery
2025-05-14 test fixes for saving data in spout sampling
    [task_spout_sampling.py]
2025-05-15 fixes to load the spout-tone map in the two-choi auditory task
    [task_twochoice_auditory.py]
2025-07-04 tests to include calibration in the GUI
2025-07-16 bug fix in transfer files
    [transfer_files.py]
2026-01-27 update code with button to play manipulator sound in the rig
2026-02-05 bug fix in two-choice auditory task
    [task_twochoice_auditory.py]
